adafruit/Adafruit-Motor-Shield-V2-PCB/Adafruit Motor Shield v2.3.brd

## EAGLE design Adafruit Motor Shield v2.3.brd (2016-10-26)

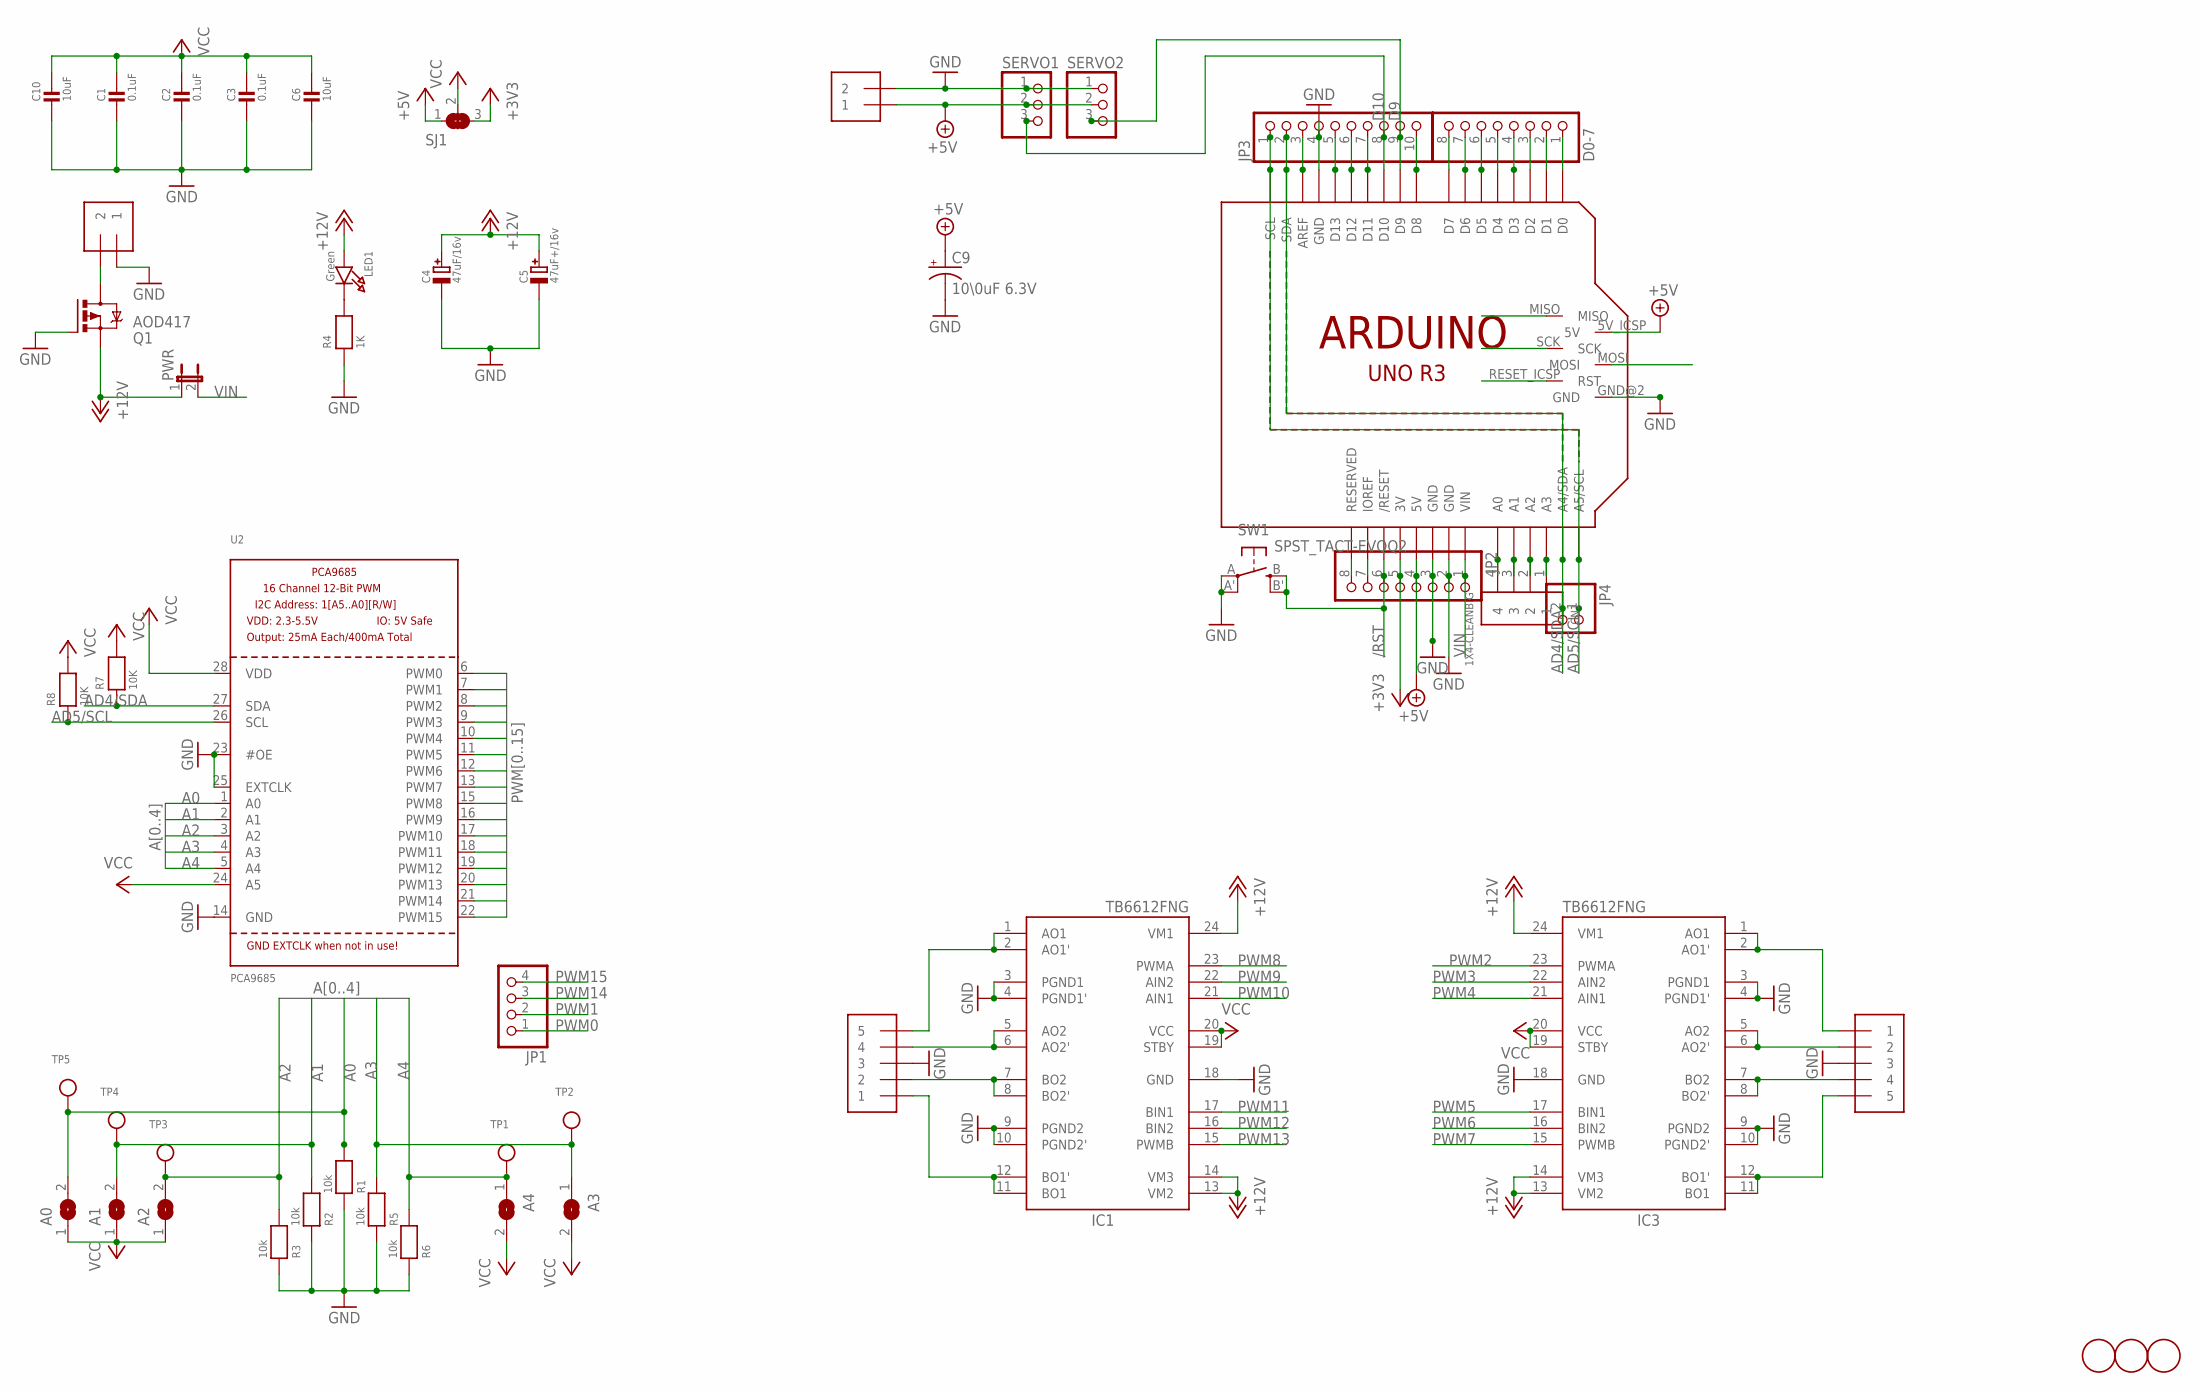
[picture p2: schematic Adafruit Motor Shield v2.3.sch]

Parts:
A0, A1, A2, A3, A4: SOLDERJUMPERREFLOW_NOPASTE; SOLDERJUMPER_REFLOW_NOPASTE
C1, C2, C3: 0.1uF; 0805-NO
C4: 47uF/16v; PANASONIC_C
C5: 47uF+/16v; PANASONIC_C
C6, C10: 10uF; 0805-NO
C9: 10\0uF 6.3V; PANASONIC_C
CN1: 1X4-CLEANBIG; 1X04-CLEANBIG
D0-7: PINHD-1X8CLEANBIG; 1X08-CLEANBIG
IC1, IC3: TB6612FNG; SSOP24
J1, J2: 1X5; 1X05-3.5MM
JP1: HEADER-1X476MIL; 1X04_ROUND_76
JP2: PINHD-1X8CLEANBIG; 1X08-CLEANBIG
JP3: HEADER-1X1070MIL; 1X10_ROUND70
JP4: HEADER-1X2ROUND; 1X02_ROUND
LED1: Green; CHIPLED_0805_NOOUTLINE
MPOWER: 1X2-3.5MM
PWR: JP1E; JP1
Q1: AOD417; D-PAK_TO252AA
R1, R2, R3, R5, R6: 10k; 0805-NO
R4: 1K; 0805-NO
R7, R8: 10K; 0805-NO
SERPWR: 1X2-3.5MM
SERVO1, SERVO2: PINHD-1X3; 1X03
SJ1: SOLDERJUMPER_2WAY; SOLDERJUMPER_2WAY_OPEN_NOPASTE
SW1: SPST_TACT-EVQQ2; EVQ-Q2
TP1, TP2, TP3, TP4, TP5: TESTPOINTROUND2MM; TESTPOINT_ROUND_2MM
U2: PCA9685; TSSOP28
U$1: ARDUINO_R3_ICSP; ARDUINOR3_ICSP
U$2, U$3, U$4: FIDUCIAL; FIDUCIAL_1MM

Connections:
+3V3: JP2.5, SJ1.3, U$1.3V
+5V: C9.+, JP2.4, SERPWR.1, SERVO1.2, SERVO2.2, SJ1.1, U$1.5V, U$1.5V_ICSP (5V)
+12V: C4.+, C5.+, IC1.13 (VM2), IC1.14 (VM3), IC1.24 (VM1), IC3.13 (VM2), IC3.14 (VM3), IC3.24 (VM1), LED1.A, PWR.1, Q1.3 (S)
/RST: JP2.6, SW1.B (S), SW1.B' (S1), U$1.RESET (/RESET), U$1.RESET_ICSP (RST)
A0: A0.2, R1.2, TP5.P$1, U2.1 (A0)
A1: A1.2, R2.2, TP4.P$1, U2.2 (A1)
A2: A2.2, R3.2, TP3.P$1, U2.3 (A2)
A3: A3.1, R5.2, TP2.P$1, U2.4 (A3)
A4: A4.1, R6.2, TP1.P$1, U2.5 (A4)
AD0: CN1.4, U$1.A0
AD1: CN1.3, U$1.A1
AD2: CN1.2, U$1.A2
AD3: CN1.1, U$1.A3
AD4/SDA: JP3.2, JP4.2, R7.1, U2.27 (SDA), U$1.A4 (A4/SDA), U$1.SDA
AD5/SCL: JP3.1, JP4.1, R8.1, U2.26 (SCL), U$1.A5 (A5/SCL), U$1.SCL
AREF: JP3.3, U$1.AREF
D0: D0-7.1, U$1.D0
D1: D0-7.2, U$1.D1
D2: D0-7.3, U$1.D2
D3: D0-7.4, U$1.D3
D4: D0-7.5, U$1.D4
D5: D0-7.6, U$1.D5
D6: D0-7.7, U$1.D6
D7: D0-7.8, U$1.D7
D8: JP3.10, U$1.D8
D9: JP3.9, SERVO2.3, U$1.D9
D10: JP3.8, SERVO1.3, U$1.D10
D11: JP3.7, U$1.D11
D12: JP3.6, U$1.D12
D13: JP3.5, U$1.D13
GND: C1.2, C2.2, C3.2, C4.-, C5.-, C6.2, C9.-, C10.2, IC1.3 (PGND1), IC1.4 (PGND1'), IC1.9 (PGND2), IC1.10 (PGND2'), IC1.18 (GND), IC3.3 (PGND1), IC3.4 (PGND1'), IC3.9 (PGND2), IC3.10 (PGND2'), IC3.18 (GND), J1.3, J2.3, JP2.2, JP2.3, JP3.4, MPOWER.1, Q1.1 (G), R1.1, R2.1, R3.1, R4.1, R5.1, R6.1, SERPWR.2, SERVO1.1, SERVO2.1, SW1.A, SW1.A' (P1), U2.14 (GND), U2.23 (#OE), U2.25 (EXTCLK), U$1.GND, U$1.GND@1 (GND), U$1.GND@2 (GND), U$1.GND@3 (GND)
IOREF: JP2.7, U$1.IOREF
M1A: IC1.1 (AO1), IC1.2 (AO1'), J1.5
M1B: IC1.5 (AO2), IC1.6 (AO2'), J1.4
M2A: IC1.11 (BO1), IC1.12 (BO1'), J1.1
M2B: IC1.7 (BO2), IC1.8 (BO2'), J1.2
M3A: IC3.1 (AO1), IC3.2 (AO1'), J2.1
M3B: IC3.5 (AO2), IC3.6 (AO2'), J2.2
M4A: IC3.11 (BO1), IC3.12 (BO1'), J2.5
M4B: IC3.7 (BO2), IC3.8 (BO2'), J2.4
MISO: U$1.MISO
MOSI: U$1.MOSI
unnamed: JP2.8, U$1.RESERVED
unnamed: LED1.C, R4.2
PWM0: JP1.1, U2.6 (PWM0)
PWM1: JP1.2, U2.7 (PWM1)
PWM2: IC3.23 (PWMA), U2.8 (PWM2)
PWM3: IC3.22 (AIN2), U2.9 (PWM3)
PWM4: IC3.21 (AIN1), U2.10 (PWM4)
PWM5: IC3.17 (BIN1), U2.11 (PWM5)
PWM6: IC3.16 (BIN2), U2.12 (PWM6)
PWM7: IC3.15 (PWMB), U2.13 (PWM7)
PWM8: IC1.23 (PWMA), U2.15 (PWM8)
PWM9: IC1.22 (AIN2), U2.16 (PWM9)
PWM10: IC1.21 (AIN1), U2.17 (PWM10)
PWM11: IC1.17 (BIN1), U2.18 (PWM11)
PWM12: IC1.16 (BIN2), U2.19 (PWM12)
PWM13: IC1.15 (PWMB), U2.20 (PWM13)
PWM14: JP1.3, U2.21 (PWM14)
PWM15: JP1.4, U2.22 (PWM15)
SCK: U$1.SCK
VCC: A0.1, A1.1, A2.1, A3.2, A4.2, C1.1, C2.1, C3.1, C6.1, C10.1, IC1.19 (STBY), IC1.20 (VCC), IC3.19 (STBY), IC3.20 (VCC), R7.2, R8.2, SJ1.2, U2.24 (A5), U2.28 (VDD)
VIN: JP2.1, PWR.2, U$1.VIN
VMOTOR: MPOWER.2, Q1.4 (D)

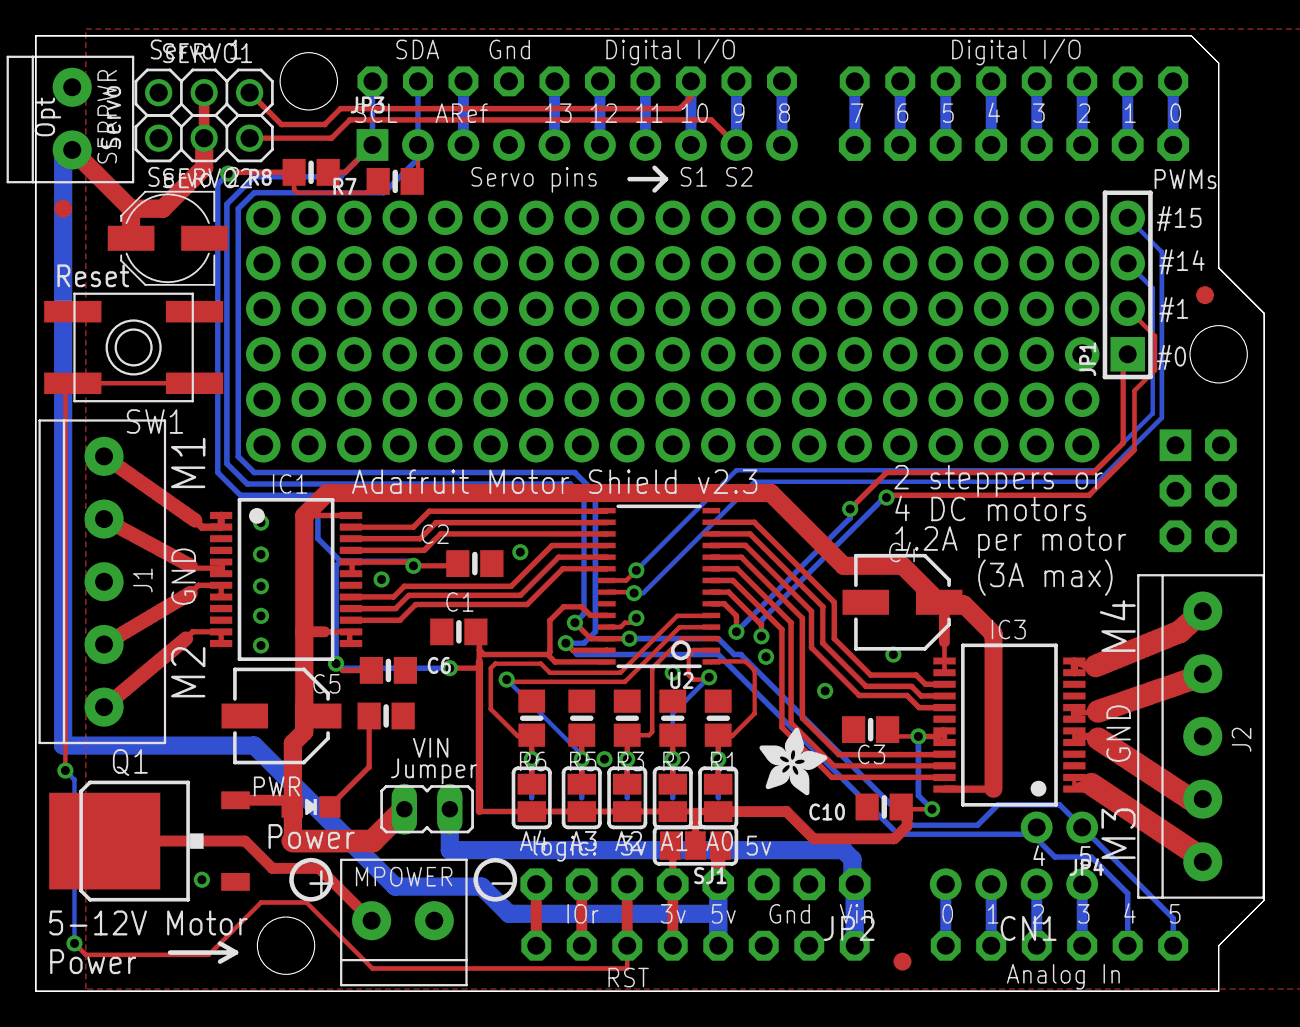
[picture p3: board Adafruit Motor Shield v2.3.brd from above]

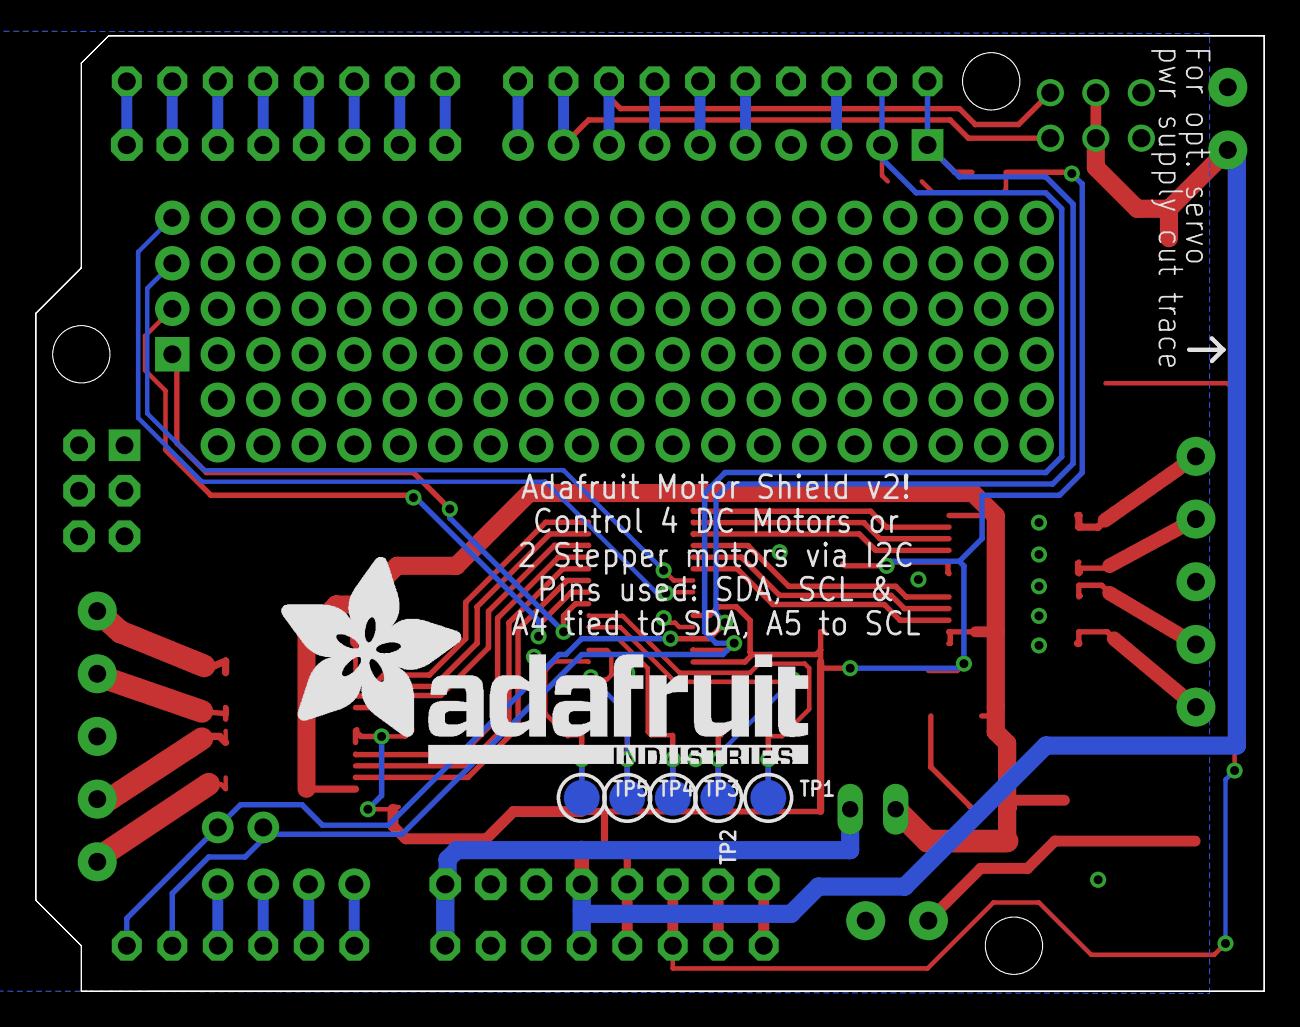
[picture p4: board Adafruit Motor Shield v2.3.brd from below]

Board: 2 copper layers, 68.6 x 53.3 mm, 52 parts (6 on the bottom side), 61 nets.

Other parts of the board:
U$5: ADAFRUIT_TEXT_30MM
U$6: ADAFRUIT_3.5MM
